EstebanValverde/Ultrafreezer-alarm/IMG_20230901_111251.jpg

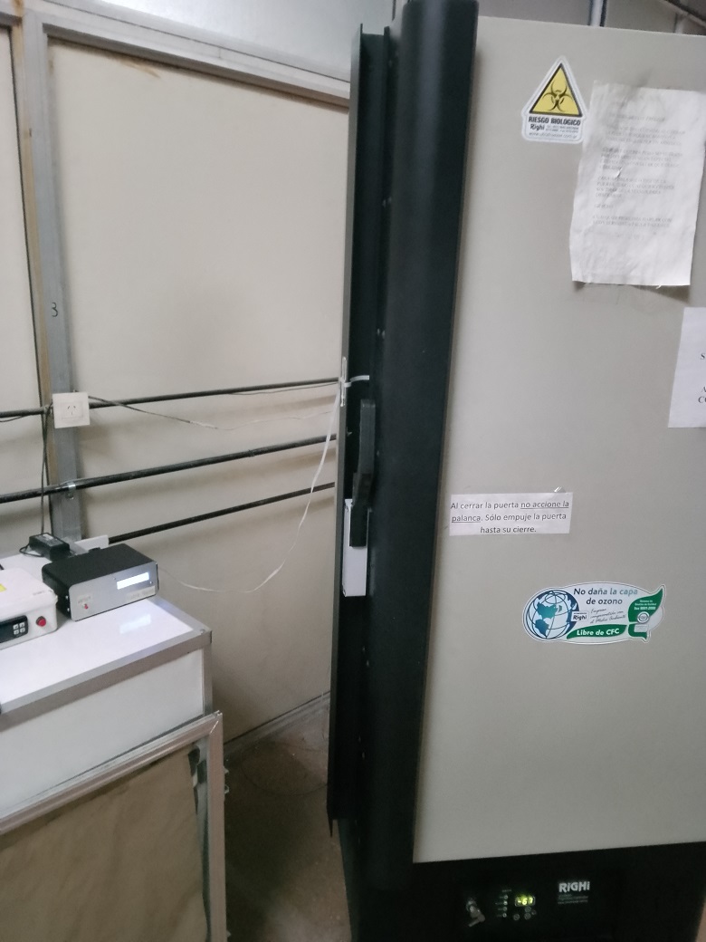
IMG_20230901_111251.jpg
