EstebanValverde/Ultrafreezer-alarm/IMG_20230901_111243.jpg

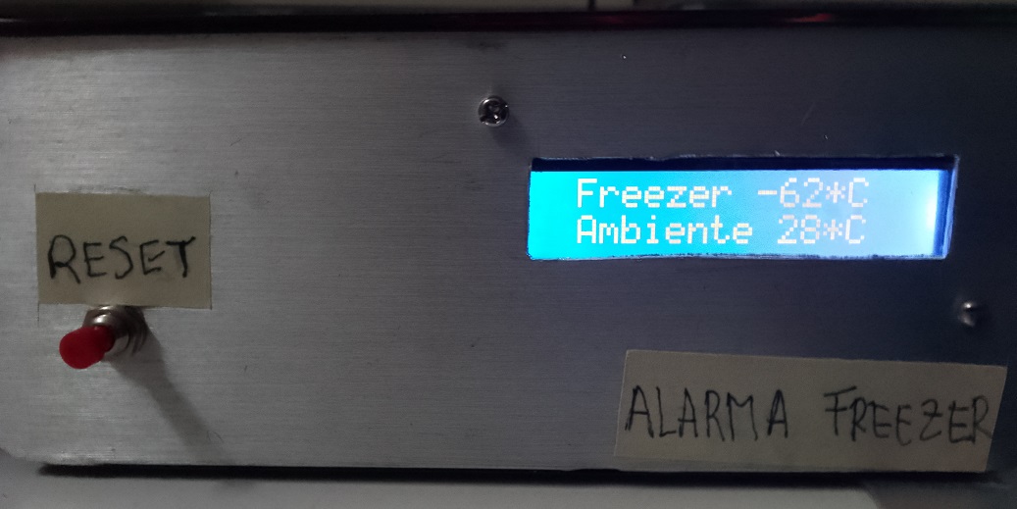
IMG_20230901_111243.jpg
