EstebanValverde/Ultrafreezer-alarm/sensorFreezer.sch

## EAGLE design sensorFreezer.sch (2024-03-20)

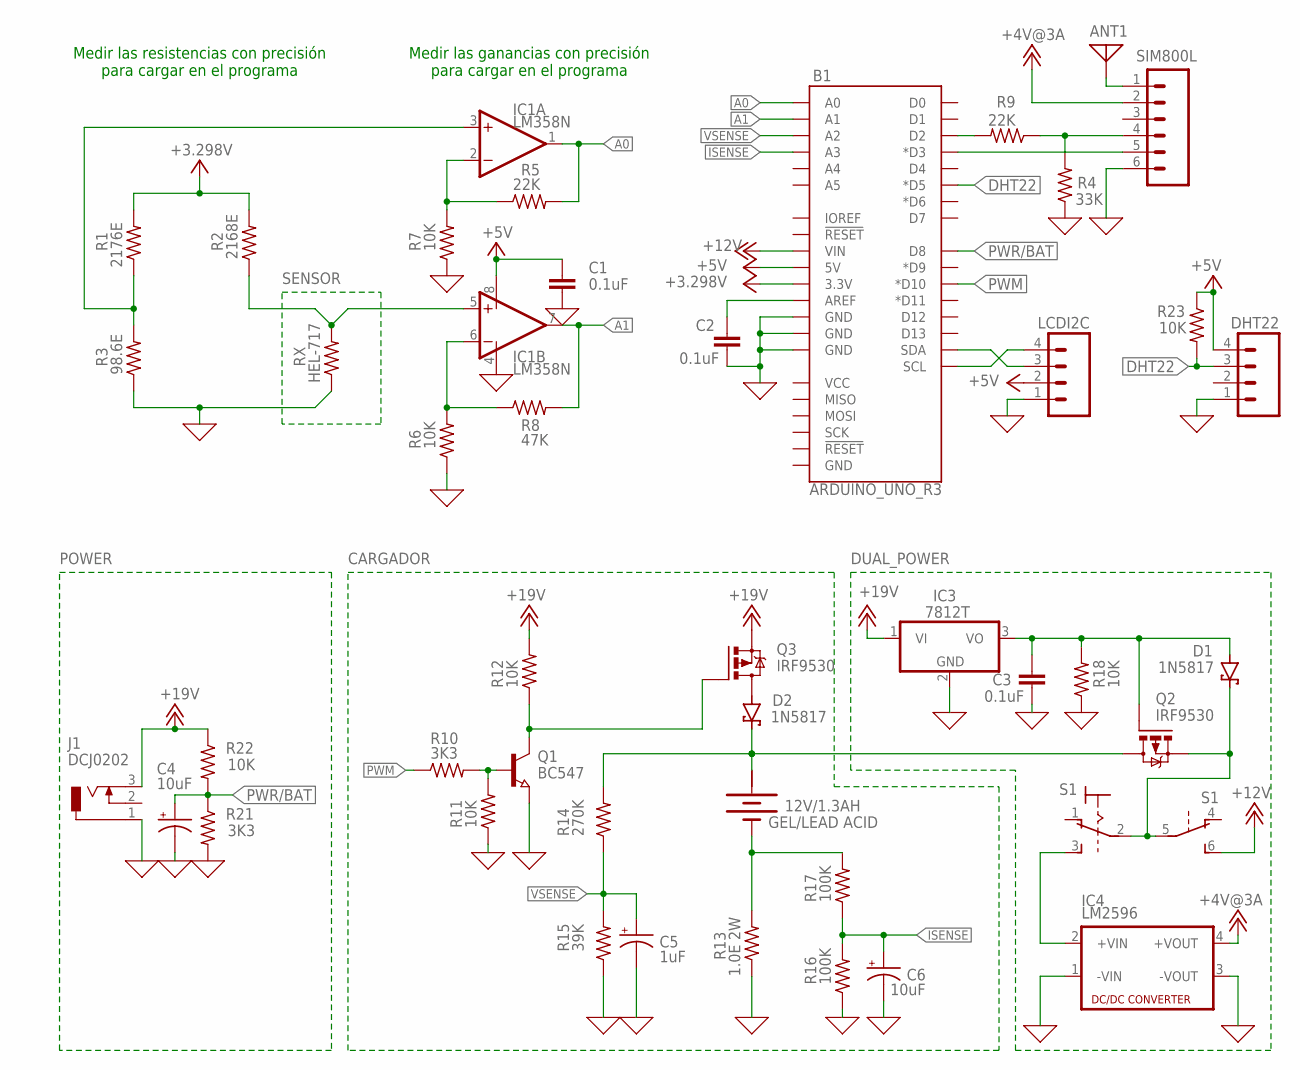
[picture p17: schematic sensorFreezer.sch]

Parts:
12V/1.3AH: GEL/LEAD ACID; BATTERY
ANT1: ANTENNA; PAD-01
B1: ARDUINO_UNO_R3; ARDUINO_R3
C1, C2, C3: 0.1uF; C2.5-3
C4, C6: 10uF; 085CS_1AR
C5: 1uF; 085CS_1AR
D1, D2: 1N5817; DO41-7.6
DHT22: M04; 04P
IC1: LM358N; DIL08
IC3: 7812T; TO220H
IC4: LM2596; NME
J1: DCJ0202
LCDI2C: M04; 04P
Q1: BC547; SOT23
Q2, Q3: IRF9530; TO220BV
R1: 2176E; 0204/5
R2: 2168E; 0204/5
R3: 98.6E; 0204/5
R4: 33K; 0204/5
R5, R9: 22K; 0204/5
R6, R7, R11, R12, R18, R22, R23: 10K; 0204/5
R8: 47K; 0204/5
R10, R21: 3K3; 0204/5
R13: 1.0E 2W; 0204/5
R14: 270K; 0204/5
R15: 39K; 0204/5
R16, R17: 100K; 0204/5
RX: HEL-717; 0204/5
S1: 320-938
SIM800L: M06; 06P

Connections:
0: B1.GND@2 (GND), B1.GND@3 (GND), B1.GND@4 (GND), C1.2, C2.2, C3.2, C4.-, C5.-, C6.-, DHT22.1, IC1.4 (V-), IC3.2 (GND), IC4.1 (-VIN), IC4.3 (-VOUT), J1.1, LCDI2C.1, Q1.2 (E), R3.1, R4.1, R6.1, R7.1, R11.1, R13.1, R15.1, R16.1, R18.1, R21.2, RX.1, SIM800L.6
+3V3: B1.3.3V, R1.2, R2.2
+5V: B1.5V, C1.1, DHT22.4, IC1.8 (V+), LCDI2C.2, R23.1
+12V: B1.VIN, IC3.1 (VI), IC4.4 (+VOUT), J1.3, Q3.S, R12.2, R22.1, S1.6 (S), SIM800L.2
A0: B1.A0, IC1.1 (OUT), R5.2
A1: B1.A1, IC1.7 (OUT), R8.2
DHT22: B1.D5 (*D5), DHT22.3, R23.2
ISENSE: B1.A3, C6.+, R16.2, R17.1
unnamed: IC1.6 (-IN), R6.2, R8.1
unnamed: IC1.5 (+IN), R2.1, RX.2
unnamed: IC1.3 (+IN), R1.1, R3.2
unnamed: IC1.2 (-IN), R5.1, R7.2
unnamed: B1.AREF, C2.1
unnamed: B1.SDA, LCDI2C.3
unnamed: B1.SCL, LCDI2C.4
unnamed: B1.D2, R9.2
unnamed: C3.1, D1.A, IC3.3 (VO), Q2.G, R18.2
unnamed: R4.2, R9.1, SIM800L.4
unnamed: B1.D3 (*D3), SIM800L.5
unnamed: ANT1.1, SIM800L.1
unnamed: Q1.1 (B), R10.2, R11.2
unnamed: Q1.3 (C), Q3.G, R12.1
unnamed: D2.A, Q3.D
unnamed: 12V/1.3AH.+, D2.C, Q2.D, R14.2
unnamed: 12V/1.3AH.-, R13.2, R17.2
unnamed: IC4.2 (+VIN), S1.3 (S)
unnamed: D1.C, Q2.S, S1.2, S1.5
PWM: B1.D10 (*D10), R10.1
PWR/BAT: B1.D8, C4.+, R21.1, R22.2
VSENSE: B1.A2, C5.+, R14.1, R15.2

Notes on the sheet:
Medir las ganancias con precisión para cargar en el programa
Medir las resistencias con precisión para cargar en el programa
